CodyGargar/dbf-carrier-board/kicad/drc-report.txt

** Drc report for /home/user/dbf-carrier-board/kicad/dbf-carrier-routed-raw.kicad_pcb **
** Created on 2026-11-07 18:07:31 **

** Found 157 DRC violations **
[silk_overlap]: Silkscreen overlap
    Rule: board setup constraints silk; Severity: warning
    @(155.7700 mm, 153.6700 mm): Line on F.Silkscreen
    @(153.2300 mm, 153.7300 mm): Line on F.Silkscreen
[silk_overlap]: Silkscreen overlap
    Rule: board setup constraints silk; Severity: warning
    @(155.7700 mm, 153.6700 mm): Line on F.Silkscreen
    @(173.5500 mm, 153.7300 mm): Line on F.Silkscreen
[silk_overlap]: Silkscreen overlap
    Rule: board setup constraints silk; Severity: warning
    @(155.7700 mm, 156.2100 mm): Line on F.Silkscreen
    @(173.5500 mm, 153.7300 mm): Line on F.Silkscreen
[silk_overlap]: Silkscreen overlap
    Rule: board setup constraints silk; Severity: warning
    @(155.7700 mm, 156.2100 mm): Line on F.Silkscreen
    @(173.6100 mm, 156.3300 mm): Line on F.Silkscreen
[silk_overlap]: Silkscreen overlap
    Rule: board setup constraints silk; Severity: warning
    @(155.7700 mm, 156.2100 mm): Line on F.Silkscreen
    @(155.7700 mm, 156.3300 mm): Line on F.Silkscreen
[silk_overlap]: Silkscreen overlap
    Rule: board setup constraints silk; Severity: warning
    @(153.2300 mm, 153.7300 mm): Line on F.Silkscreen
    @(173.6100 mm, 156.3300 mm): Line on F.Silkscreen
[silk_overlap]: Silkscreen overlap
    Rule: board setup constraints silk; Severity: warning
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
[courtyards_overlap]: Courtyards overlap
    Rule: board setup constraints courtyard; Severity: error
    @(110.5000 mm, 157.5400 mm): Footprint J22
    @(110.5000 mm, 155.0000 mm): Footprint J21

** Found 0 unconnected pads **

** Found 0 Footprint errors **

** End of Report **
