CodyGargar/dbf-carrier-board/pinout.csv

Teensy pin | Function | Bus | Connects to | Notes
2 | Servo out CH1 | PWM | Mux U6 A1 | Stabilized surface (e.g. left aileron)
3 | Servo out CH2 | PWM | Mux U6 A2 | Stabilized surface (e.g. right aileron)
4 | Servo out CH3 | PWM | Mux U6 A3 | Stabilized surface (e.g. elevator)
5 | Servo out CH4 | PWM | Mux U6 A4 | Stabilized surface (e.g. rudder)
6 | Servo out CH5 | PWM | Mux U7 A1 | Stabilized surface (e.g. left flap)
9 | Servo out CH6 | PWM | Mux U7 A2 | Stabilized surface (e.g. right flap)
22 | Throttle out CH7 (T) | PWM | Mux U7 A3 | Through open-drain buffer U9 to ESC; Castle Link Live. T column + pin not connected (ESC BEC isolated)
23 | Spare out CH8 | PWM | Mux U7 A4 | Spare
24 | Watchdog heartbeat | GPIO out | U8 74LVC1G123 | Toggle from main loop; stops = receiver takes over
25 | Failover status | GPIO in | U8 Q output | High = Teensy in control
28 | ESC telemetry (Castle Link Live) | GPIO in | Throttle line via 1k | Times the ESC's reply pulses on the throttle wire
0 | Test radio RX1 | Serial1 | J11 | SiK / ESP32 for test flights only; unplug for competition
1 | Test radio TX1 | Serial1 | J11
10 | IMU CS | SPI | ICM-42688-P
11 | IMU MOSI | SPI | ICM-42688-P
12 | IMU MISO | SPI | ICM-42688-P
13 | IMU SCK | SPI | ICM-42688-P
30 | IMU INT | GPIO in | ICM-42688-P | Data-ready interrupt
14 | Receiver CRSF TX3 | Serial3 | J6 pin 3 | Telemetry to radio; to ER8 RX
15 | Receiver CRSF RX3 | Serial3 | J6 pin 4 | Sticks from radio; from ER8 TX. J6 pin 1 GND; pin 2 receiver +5V not connected
16 | Airspeed SCL1 | Wire1 | J4
17 | Airspeed SDA1 | Wire1 | J4
18 | Baro SDA | Wire | DPS368
19 | Baro SCL | Wire | DPS368
32 | Event button | GPIO in | SW1 | Hold at power-up = calibrate; tap = log mark / start-stop
33 | Buzzer | GPIO out | Q1
36 | LED green | GPIO out | D2
37 | LED red | GPIO out | D3
40 | Battery V (A16) | Analog | J7 | Optional power module
41 | Battery I (A17) | Analog | J7 | Optional power module
VIN | 5 V in | Power | Schottky from 5 V regulator
GND | Ground | Power
3V3 | Not used as supply | Power |  | Sensors use their own 3.3 V LDO
7 8 20 21 26 27 29 31 34 35 38 39 | Unused
