CodyGargar/dbf-carrier-board/kicad/board-inner-planes.png

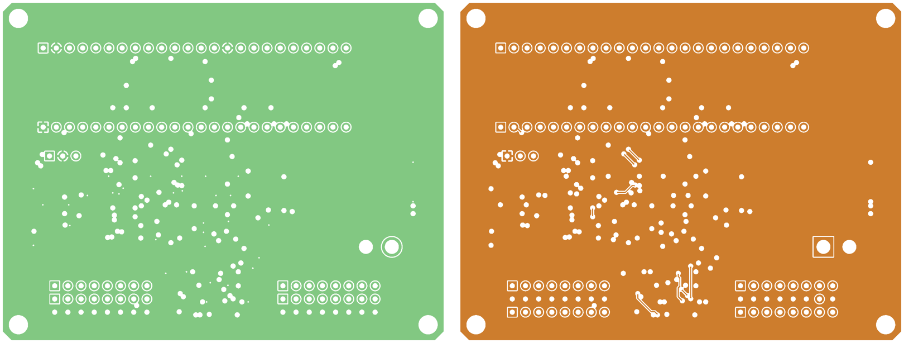
kicad/board-inner-planes.png
