CodyGargar/dbf-carrier-board/bom.csv

Section | Item | Part / model | Qty | Unit price ($) | Line total ($) | Link | Price status | Notes
A. Plane electronics (one set per plane) | Microcontroller | Teensy 4.1 (DEV-16771) | 1 | 31.5 | 31.5 | https://www.sparkfun.com/teensy-4-1.html | Checked 2026-10-12 | SparkFun now makes Teensy. Comes without pins.
A. Plane electronics (one set per plane) | Pins for the Teensy | Male header, 24-pin, 0.1in | 2 | 1.85 | 3.7 | https://www.sparkfun.com/straight-header-male-gold-plating-pth-0-1in-24-pin.html | Checked 2026-10-12 | Solder these onto the Teensy so it plugs into the board.
A. Plane electronics (one set per plane) | Airspeed sensor | Matek ASPD-4525 (MS4525DO) | 1 | 59.99 | 59.99 | https://racedayquads.com/products/matek-analog-airspeed-sensor-aspd-4525 | Checked 2026-10-12 | Kit includes pitot tube and rubber tubing.
A. Plane electronics (one set per plane) | RC receiver | RadioMaster ER8 ELRS PWM (team already has) | 0 | 0 | 0 | https://www.radiomasterrc.com/products/er8-2-4ghz-elrs-pwm-receiver | Already owned | 8 PWM + 4-pin CRSF port. Needs 7 backup channels + 1 for the drop servos. An ER6 is too small.
A. Plane electronics (one set per plane) | Y-cable for the 2 drop servos | Servo Y-harness | 1 | 3 | 3 | https://www.amazon.com/s?k=servo+y+harness | Estimate | Both drop servos on receiver channel 8.
A. Plane electronics (one set per plane) | ESC programmer | Castle Link USB programming kit | 1 | 30 | 30 | https://www.castlecreations.com/en/castle-link-usb-programming-kit-011-0119-00 | Estimate | Turns on Link Live telemetry and disables the BEC. Skip if the team owns one.
A. Plane electronics (one set per plane) | Test radio for laptop (testing only) | SiK telemetry radio pair, 915 MHz | 1 | 60 | 60 | https://www.amazon.com/s?k=sik+telemetry+radio+915mhz | Estimate | Unplug for competition: stand-alone telemetry radios are banned there. USB works on the bench for free.
A. Plane electronics (one set per plane) | Battery current sensing (backup) | Holybro PM02 V3 (sense only) | 0 | 18.99 | 0.0 | https://holybro.com/products/pm02-v3-12s-power-module | Checked 2026-10-12 | Not needed: the Castle ESC reports current over Link Live. Set qty 1 only if Link Live doesn't work out.
A. Plane electronics (one set per plane) | Cables for airspeed / receiver / sensing | JST-GH 1.25 mm pre-crimped cable kit | 1 | 12 | 12 | https://www.amazon.com/s?k=JST+GH+1.25mm+pre-crimped+cable | Estimate | Get 2-, 4- and 6-pin, 15-20 cm.
B. Board order (JLCPCB: 5 bare boards, 2 assembled) | Bare PCBs | 4-layer, ~86 x 66 mm, qty 5 | 1 | 10 | 10 | https://jlcpcb.com/quote | Estimate | Get the real price by uploading the Gerber files once the design is finished.
B. Board order (JLCPCB: 5 bare boards, 2 assembled) | Assembly setup + stencil | JLCPCB PCBA, economic, 2 boards | 1 | 12 | 12 | https://jlcpcb.com/quote | Estimate | Assembling only 2 of the 5 boards saves money because the IMU is expensive.
B. Board order (JLCPCB: 5 bare boards, 2 assembled) | Extended-part fees | ~8 part types x ~$3 | 1 | 24 | 24 | https://jlcpcb.com/quote | Estimate | JLCPCB charges a loading fee per uncommon part type.
B. Board order (JLCPCB: 5 bare boards, 2 assembled) | IMU (factory soldered) | TDK ICM-42688-P (LCSC C1850418) | 2 | 20.5 | 41.0 | https://www.lcsc.com/product-detail/C1850418.html | Checked 2026-10-12 | 355 in stock when checked.
B. Board order (JLCPCB: 5 bare boards, 2 assembled) | Barometer (factory soldered) | Infineon DPS368XTSA1 (LCSC C3232508) | 2 | 4.42 | 8.84 | https://www.lcsc.com/product-detail/C3232508.html | Checked 2026-10-12 | Replaces DPS310 (out of stock). Pinout to be confirmed during the schematic step.
B. Board order (JLCPCB: 5 bare boards, 2 assembled) | 3.3 V regulator | AP2112K-3.3 | 2 | 0.3 | 0.6 | https://jlcpcb.com/parts/componentSearch?searchTxt=AP2112K-3.3 | Estimate
B. Board order (JLCPCB: 5 bare boards, 2 assembled) | Failover mux (factory soldered) | TI SN74LVC157A, TSSOP-16 | 4 | 0.35 | 1.4 | https://jlcpcb.com/parts/componentSearch?searchTxt=SN74LVC157APWR | Estimate | 2 per board: hands servos back to the receiver.
B. Board order (JLCPCB: 5 bare boards, 2 assembled) | Watchdog timer (factory soldered) | 74LVC1G123, VSSOP-8 | 2 | 0.45 | 0.9 | https://jlcpcb.com/parts/componentSearch?searchTxt=74LVC1G123 | Estimate | Switches to the receiver if the Teensy stops.
B. Board order (JLCPCB: 5 bare boards, 2 assembled) | Throttle buffer (factory soldered) | 74LVC1G07, SOT-353 | 2 | 0.15 | 0.3 | https://jlcpcb.com/parts/componentSearch?searchTxt=74LVC1G07 | Estimate | Open-drain stage for Castle Link Live.
B. Board order (JLCPCB: 5 bare boards, 2 assembled) | JST-GH 6-pin connector (factory soldered) | JST SM06B-GHS-TB | 2 | 0.8 | 1.6 | https://www.digikey.com/en/products/result?keywords=SM06B-GHS-TB | Estimate | Battery V/I sensing.
B. Board order (JLCPCB: 5 bare boards, 2 assembled) | JST-GH 4-pin connector (factory soldered) | JST SM04B-GHS-TB | 6 | 0.7 | 4.2 | https://www.digikey.com/en/products/result?keywords=SM04B-GHS-TB | Estimate | 3 per board: airspeed, receiver CRSF, test radio.
B. Board order (JLCPCB: 5 bare boards, 2 assembled) | Buzzer (factory soldered) | CUI CMT-8504-100-SMT | 2 | 1.8 | 3.6 | https://www.digikey.com/en/products/result?keywords=CMT-8504-100-SMT | Estimate
B. Board order (JLCPCB: 5 bare boards, 2 assembled) | Small parts per board | Resistors, caps, LEDs, diode, transistor | 2 | 2 | 4 | https://jlcpcb.com/parts/componentSearch?searchTxt=0603 | Estimate | Mostly JLCPCB basic parts (cents each).
B. Board order (JLCPCB: 5 bare boards, 2 assembled) | Shipping + import fees | JLCPCB to US | 1 | 30 | 30 | https://jlcpcb.com/quote | Estimate | Biggest unknown; check at checkout.
C. Parts you solder yourself (for the 2 assembled boards) | 5 V regulator module | Pololu S7V7F5 (2.7-11.8 V in) | 2 | 8.49 | 16.98 | https://www.pololu.com/product/2119 | Checked 2026-10-17 | Runs the board from the receiver battery.
C. Parts you solder yourself (for the 2 assembled boards) | Teensy sockets | Female header 1x24, gold (2-pack) | 2 | 0.85 | 1.7 | https://protosupplies.com/product/header-female-1x24-gold-2-pack/ | Checked 2026-10-12 | One 2-pack per board.
C. Parts you solder yourself (for the 2 assembled boards) | Servo headers | Male header 1x8, 0.1in | 12 | 0.4 | 4.8 | https://www.digikey.com/en/products/result?keywords=1x8+male+header+2.54 | Estimate | 6 per board: two 3x8 blocks (from receiver, to servos).
C. Parts you solder yourself (for the 2 assembled boards) | Receiver battery input | AMASS XT30U male, PCB | 2 | 1 | 2 | https://www.digikey.com/en/products/result?keywords=XT30 | Estimate | From the external radio switch.
C. Parts you solder yourself (for the 2 assembled boards) | Event button | 6 mm tactile switch (TL3342 footprint) | 2 | 0.4 | 0.8 | https://www.digikey.com/en/products/result?keywords=TL3342 | Estimate
