CodyGargar/dbf-carrier-board/parts-list.xlsx

DBF Logger + Stabilizer Rev B: Parts List
Prices marked "Checked" were read from the seller page in October 2026; "Estimate" rows are ballpark. Change any Qty cell (blue) and totals update.
Item | Part / model | Qty | Unit price ($) | Line total ($) | Buy link | Price status | Notes
A. Plane electronics (one set per plane)
Microcontroller | Teensy 4.1 (DEV-16771) | 1 | $31.50 |  | Open link (https://www.sparkfun.com/teensy-4-1.html) | Checked 2026-10-12 | SparkFun now makes Teensy. Comes without pins.
Pins for the Teensy | Male header, 24-pin, 0.1in | 2 | $1.85 |  | Open link (https://www.sparkfun.com/straight-header-male-gold-plating-pth-0-1in-24-pin.html) | Checked 2026-10-12 | Solder these onto the Teensy so it plugs into the board.
Airspeed sensor | Matek ASPD-4525 (MS4525DO) | 1 | $59.99 |  | Open link (https://racedayquads.com/products/matek-analog-airspeed-sensor-aspd-4525) | Checked 2026-10-12 | Kit includes pitot tube and rubber tubing.
RC receiver | RadioMaster ER8 ELRS PWM (team already has) | 0 | $0.00 |  | Open link (https://www.radiomasterrc.com/products/er8-2-4ghz-elrs-pwm-receiver) | Already owned | 8 PWM + 4-pin CRSF port. Needs 7 backup channels + 1 for the drop servos. An ER6 is too small.
Y-cable for the 2 drop servos | Servo Y-harness | 1 | $3.00 |  | Open link (https://www.amazon.com/s?k=servo+y+harness) | Estimate | Both drop servos on receiver channel 8.
ESC programmer | Castle Link USB programming kit | 1 | $30.00 |  | Open link (https://www.castlecreations.com/en/castle-link-usb-programming-kit-011-0119-00) | Estimate | Turns on Link Live telemetry and disables the BEC. Skip if the team owns one.
Test radio for laptop (testing only) | SiK telemetry radio pair, 915 MHz | 1 | $60.00 |  | Open link (https://www.amazon.com/s?k=sik+telemetry+radio+915mhz) | Estimate | Unplug for competition: stand-alone telemetry radios are banned there. USB works on the bench for free.
Battery current sensing (backup) | Holybro PM02 V3 (sense only) | 0 | $18.99 |  | Open link (https://holybro.com/products/pm02-v3-12s-power-module) | Checked 2026-10-12 | Not needed: the Castle ESC reports current over Link Live. Set qty 1 only if Link Live doesn't work out.
Cables for airspeed / receiver / sensing | JST-GH 1.25 mm pre-crimped cable kit | 1 | $12.00 |  | Open link (https://www.amazon.com/s?k=JST+GH+1.25mm+pre-crimped+cable) | Estimate | Get 2-, 4- and 6-pin, 15-20 cm.
 |  |  | Subtotal
B. Board order (JLCPCB: 5 bare boards, 2 assembled)
Bare PCBs | 4-layer, ~86 x 66 mm, qty 5 | 1 | $10.00 |  | Open link (https://jlcpcb.com/quote) | Estimate | Get the real price by uploading the Gerber files once the design is finished.
Assembly setup + stencil | JLCPCB PCBA, economic, 2 boards | 1 | $12.00 |  | Open link (https://jlcpcb.com/quote) | Estimate | Assembling only 2 of the 5 boards saves money because the IMU is expensive.
Extended-part fees | ~8 part types x ~$3 | 1 | $24.00 |  | Open link (https://jlcpcb.com/quote) | Estimate | JLCPCB charges a loading fee per uncommon part type.
IMU (factory soldered) | TDK ICM-42688-P (LCSC C1850418) | 2 | $20.50 |  | Open link (https://www.lcsc.com/product-detail/C1850418.html) | Checked 2026-10-12 | 355 in stock when checked.
Barometer (factory soldered) | Infineon DPS368XTSA1 (LCSC C3232508) | 2 | $4.42 |  | Open link (https://www.lcsc.com/product-detail/C3232508.html) | Checked 2026-10-12 | Replaces DPS310 (out of stock). Pinout to be confirmed during the schematic step.
3.3 V regulator | AP2112K-3.3 | 2 | $0.30 |  | Open link (https://jlcpcb.com/parts/componentSearch?searchTxt=AP2112K-3.3) | Estimate
Failover mux (factory soldered) | TI SN74LVC157A, TSSOP-16 | 4 | $0.35 |  | Open link (https://jlcpcb.com/parts/componentSearch?searchTxt=SN74LVC157APWR) | Estimate | 2 per board: hands servos back to the receiver.
Watchdog timer (factory soldered) | 74LVC1G123, VSSOP-8 | 2 | $0.45 |  | Open link (https://jlcpcb.com/parts/componentSearch?searchTxt=74LVC1G123) | Estimate | Switches to the receiver if the Teensy stops.
Throttle buffer (factory soldered) | 74LVC1G07, SOT-353 | 2 | $0.15 |  | Open link (https://jlcpcb.com/parts/componentSearch?searchTxt=74LVC1G07) | Estimate | Open-drain stage for Castle Link Live.
JST-GH 6-pin connector (factory soldered) | JST SM06B-GHS-TB | 2 | $0.80 |  | Open link (https://www.digikey.com/en/products/result?keywords=SM06B-GHS-TB) | Estimate | Battery V/I sensing.
JST-GH 4-pin connector (factory soldered) | JST SM04B-GHS-TB | 6 | $0.70 |  | Open link (https://www.digikey.com/en/products/result?keywords=SM04B-GHS-TB) | Estimate | 3 per board: airspeed, receiver CRSF, test radio.
Buzzer (factory soldered) | CUI CMT-8504-100-SMT | 2 | $1.80 |  | Open link (https://www.digikey.com/en/products/result?keywords=CMT-8504-100-SMT) | Estimate
Small parts per board | Resistors, caps, LEDs, diode, transistor | 2 | $2.00 |  | Open link (https://jlcpcb.com/parts/componentSearch?searchTxt=0603) | Estimate | Mostly JLCPCB basic parts (cents each).
Shipping + import fees | JLCPCB to US | 1 | $30.00 |  | Open link (https://jlcpcb.com/quote) | Estimate | Biggest unknown; check at checkout.
 |  |  | Subtotal
C. Parts you solder yourself (for the 2 assembled boards)
5 V regulator module | Pololu S7V7F5 (2.7-11.8 V in) | 2 | $8.49 |  | Open link (https://www.pololu.com/product/2119) | Checked 2026-10-17 | Runs the board from the receiver battery.
Teensy sockets | Female header 1x24, gold (2-pack) | 2 | $0.85 |  | Open link (https://protosupplies.com/product/header-female-1x24-gold-2-pack/) | Checked 2026-10-12 | One 2-pack per board.
Servo headers | Male header 1x8, 0.1in | 12 | $0.40 |  | Open link (https://www.digikey.com/en/products/result?keywords=1x8+male+header+2.54) | Estimate | 6 per board: two 3x8 blocks (from receiver, to servos).
Receiver battery input | AMASS XT30U male, PCB | 2 | $1.00 |  | Open link (https://www.digikey.com/en/products/result?keywords=XT30) | Estimate | From the external radio switch.
Event button | 6 mm tactile switch (TL3342 footprint) | 2 | $0.40 |  | Open link (https://www.digikey.com/en/products/result?keywords=TL3342) | Estimate
 |  |  | Subtotal
 |  |  | TOTAL
Not included: receiver battery + external radio switch, servos, ESC, motor, propulsion battery, fuse harness, arming plug, RC transmitter. Not allowed by the 2027 rules: GPS.
