CodyGargar/dbf-carrier-board/jlcpcb/bom-jlcpcb.csv

Comment | Designator | Footprint | LCSC Part #
CMT-8504-100-SMT-TR | BZ1 | MagneticBuzzer_CUI_CMT-8504-100-SMT
10uF 25V X5R 0805 | C1,C2 | C_0805_2012Metric
100nF X7R 0603 | C3,C4,C6,C8,C9,C10,C11 | C_0603_1608Metric
10nF X7R 0603 | C5 | C_0603_1608Metric
0.47uF X7R 0603 (watchdog timing) | C7 | C_0603_1608Metric
2.2uF X7R 0603 | C12 | C_0603_1608Metric
SS24 (SMA) | D1 | D_SMA
Green LED 0603 | D2 | LED_0603_1608Metric
Red LED 0603 | D3 | LED_0603_1608Metric
1N4148W (SOD-123) | D4 | D_SOD-123
SM04B-GHS-TB(LF)(SN) | J4,J6,J11 | JST_GH_SM04B-GHS-TB_1x04-1MP_P1.25mm_Horizontal
SM06B-GHS-TB(LF)(SN) | J7 | JST_GH_SM06B-GHS-TB_1x06-1MP_P1.25mm_Horizontal
MMBT3904 | Q1 | SOT-23
10k | R1,R9 | R_0603_1608Metric
4.7k | R2,R3 | R_0603_1608Metric
2.2k | R4,R5 | R_0603_1608Metric
1k | R6,R7,R10 | R_0603_1608Metric
100k 1% (watchdog timing) | R8 | R_0603_1608Metric
100k | R11 | R_0603_1608Metric
18R 0805 | R12 | R_0805_2012Metric
TL3342F160QG | SW1 | SW_SPST_TL3342
ICM-42688-P | U2 | Bosch_LGA-14_3x2.5mm_P0.5mm
DPS368XTSA1 | U3 | Bosch_LGA-8_2x2.5mm_P0.65mm_ClockwisePinNumbering
AP2112K-3.3TRG1 | U4 | SOT-23-5
SN74LVC157APWR | U6,U7 | TSSOP-16_4.4x5mm_P0.65mm
SN74LVC1G123DCUR | U8 | VSSOP-8_2.3x2mm_P0.5mm
SN74LVC1G07DCKR | U9 | SOT-353_SC-70-5
