CodyGargar/dbf-carrier-board/wiring/avionics-wiring.png

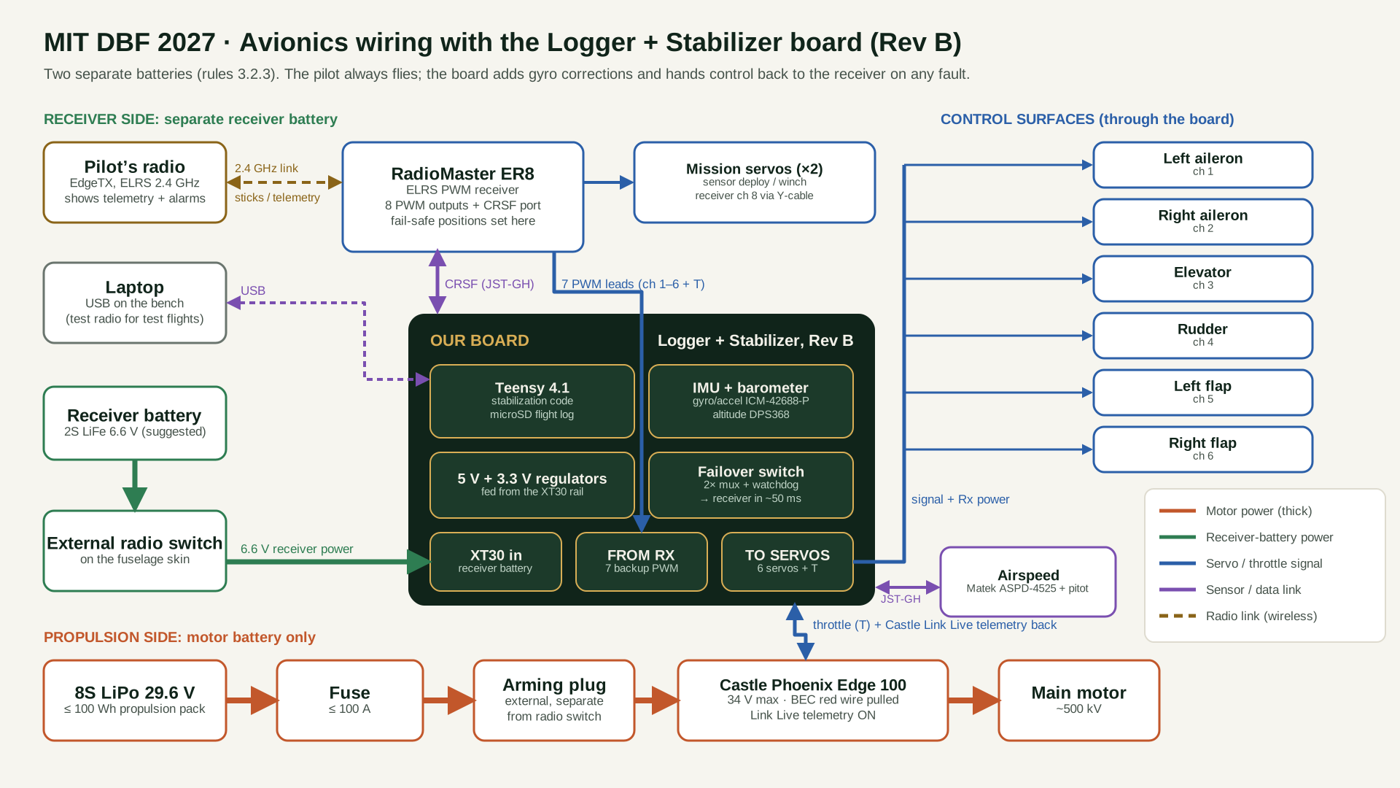
wiring/avionics-wiring.png
