CodyGargar/dbf-carrier-board/kicad/dbf-carrier.kicad_pcb

## KiCad design kicad/dbf-carrier.kicad_pcb (2026-11-07)

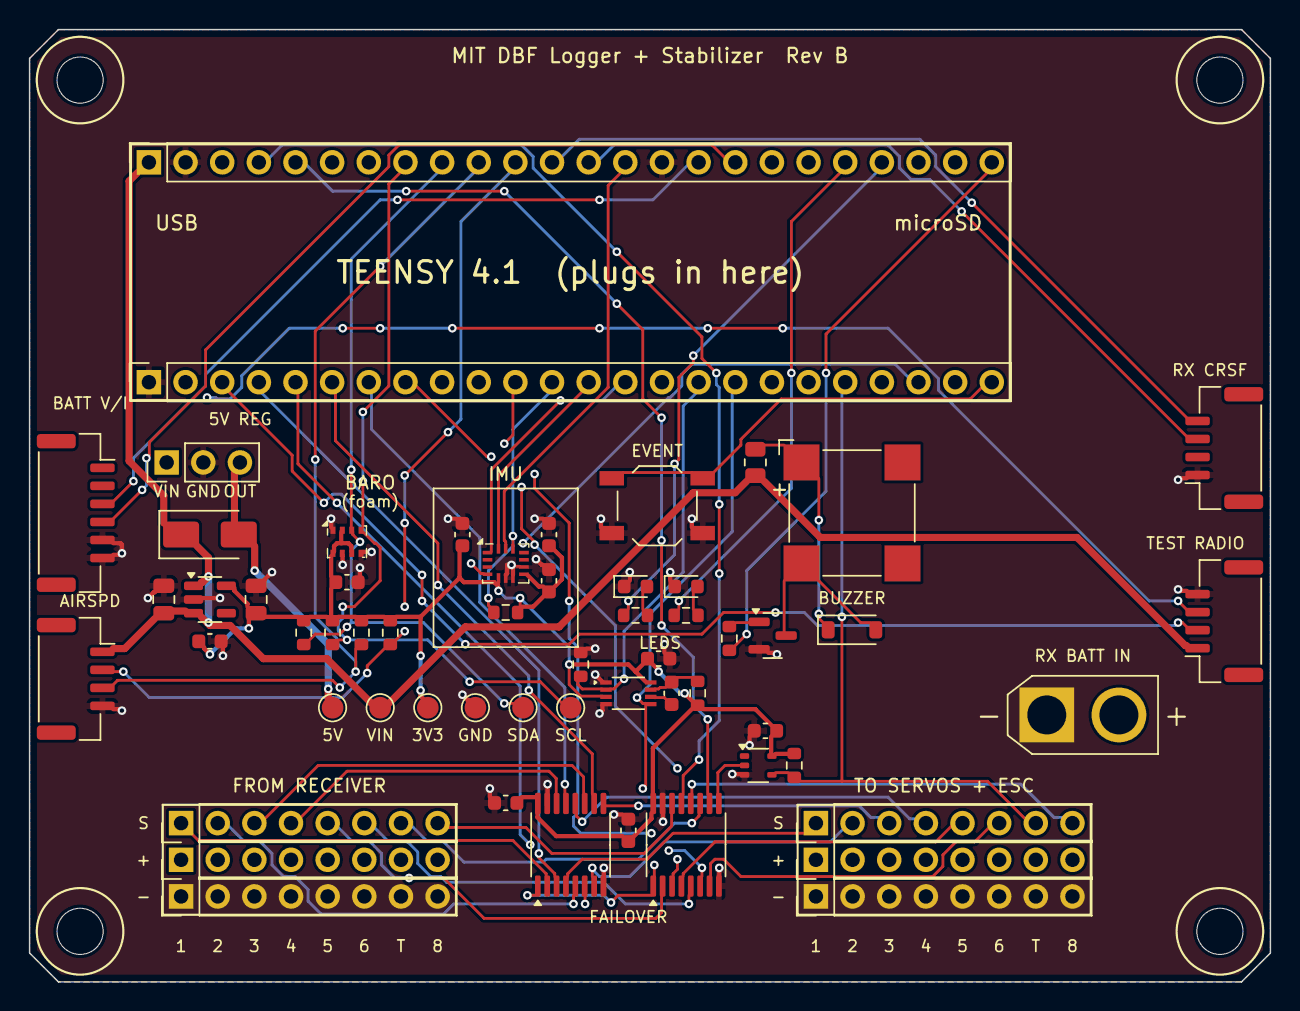
[picture p4: board dbf-carrier.kicad_pcb from above]

Board: 4 copper layers, 86.0 x 66.0 mm, 62 parts (0 on the bottom side), 58 nets.

Parts:
BZ1: Buzzer; MagneticBuzzer_CUI_CMT-8504-100-SMT
C1, C2: 10uF; C_0805_2012Metric
C3, C4, C5, C6, C8, C9, C10, C11: 100nF; C_0603_1608Metric
C7: watchdog RC; C_0603_1608Metric
C12: 2.2uF; C_0603_1608Metric
D1: SS24 Schottky; D_SMA
D2: GRN; LED_0603_1608Metric
D3: RED; LED_0603_1608Metric
D4: 1N4148W flyback; D_SOD-123
H1, H2, H3, H4: M3; MountingHole_3.2mm_M3
J1: Teensy row A; PinSocket_1x24_P2.54mm_Vertical
J2: Teensy row B; PinSocket_1x24_P2.54mm_Vertical
J4: Airspeed; JST_GH_SM04B-GHS-TB_1x04-1MP_P1.25mm_Horizontal
J6: RX CRSF; JST_GH_SM04B-GHS-TB_1x04-1MP_P1.25mm_Horizontal
J7: Power module (sense only); JST_GH_SM06B-GHS-TB_1x06-1MP_P1.25mm_Horizontal
J11: Test radio (testing only); JST_GH_SM04B-GHS-TB_1x04-1MP_P1.25mm_Horizontal
J12: Rx battery in (from radio switch); AMASS_XT30U-M_1x02_P5.0mm_Vertical
J21: FROM RECEIVER S; PinHeader_1x08_P2.54mm_Vertical
J22: FROM RECEIVER +; PinHeader_1x08_P2.54mm_Vertical
J23: FROM RECEIVER -; PinHeader_1x08_P2.54mm_Vertical
J31: TO SERVOS + ESC S; PinHeader_1x08_P2.54mm_Vertical
J32: TO SERVOS + ESC +; PinHeader_1x08_P2.54mm_Vertical
J33: TO SERVOS + ESC -; PinHeader_1x08_P2.54mm_Vertical
Q1: MMBT3904 NPN; SOT-23
R1: 10k CS pull-up; R_0603_1608Metric
R2: 4.7k SDA; R_0603_1608Metric
R3: 4.7k SCL; R_0603_1608Metric
R4: 2.2k SDA1; R_0603_1608Metric
R5: 2.2k SCL1; R_0603_1608Metric
R6, R7: 1k; R_0603_1608Metric
R8: watchdog RC; R_0603_1608Metric
R9: 10k throttle pull-up; R_0603_1608Metric
R10: 1k buzzer base; R_0603_1608Metric
R11: 100k heartbeat pull-down; R_0603_1608Metric
R12: 18R buzzer current limit; R_0805_2012Metric
SW1: Event button; SW_SPST_TL3342
TP1: 5V; TestPoint_Pad_D1.5mm
TP2: VIN; TestPoint_Pad_D1.5mm
TP3: 3V3; TestPoint_Pad_D1.5mm
TP4: GND; TestPoint_Pad_D1.5mm
TP5: SDA; TestPoint_Pad_D1.5mm
TP6: SCL; TestPoint_Pad_D1.5mm
U2: ICM-42688-P; Bosch_LGA-14_3x2.5mm_P0.5mm
U3: DPS368; Bosch_LGA-8_2x2.5mm_P0.65mm_ClockwisePinNumbering
U4: AP2112K-3.3; SOT-23-5
U5: Pololu S7V7F5 5V reg; PinHeader_1x03_P2.54mm_Vertical
U6: SN74LVC157A ch1-4; TSSOP-16_4.4x5mm_P0.65mm
U7: SN74LVC157A ch5-8; TSSOP-16_4.4x5mm_P0.65mm
U8: 74LVC1G123 watchdog; VSSOP-8_2.3x2mm_P0.5mm
U9: 74LVC1G07 throttle open-drain; SOT-353_SC-70-5

Connections:
+3V3S: C2.1, C3.1, C4.1, C5.1, C6.1, C8.2, C9.1, C10.1, C11.2, C12.1, R1.2, R2.2, R3.2, R4.2, R5.2, R8.2, R9.2, TP3.1, U2.5, U2.8, U3.2, U3.6, U3.8, U4.5, U6.16, U7.16, U8.3, U8.8, U9.5
+5V: D1.2, TP1.1, U5.3
BATT_I: J1.16, J7.3
BATT_V: J1.17, J7.4
BTN: J2.24, SW1.1
BUZ: J1.24, R10.1
BUZ_B: Q1.1, R10.2
BUZ_C: BZ1.2, D4.2, Q1.3
BUZ_P: BZ1.1, D4.1, R12.2
CRSF_RX: J1.12, J6.4
CRSF_TX: J1.13, J6.3
GND: C1.2, C2.2, C3.2, C4.2, C5.2, C6.2, C8.1, C9.2, C10.2, C11.1, C12.2, D2.1, D3.1, J1.2, J1.15, J2.1, J4.4, J6.1, J7.5, J7.6, J11.4, J12.1, J23.1, J23.2, J23.3, J23.4, J23.5, J23.6, J23.7, J23.8, J33.1, J33.2, J33.3, J33.4, J33.5, J33.6, J33.7, J33.8, Q1.2, R11.2, SW1.2, TP4.1, U2.6, U2.7, U2.9, U3.1, U3.5, U3.7, U4.2, U5.2, U6.8, U6.15, U7.8, U7.15, U8.1, U8.4, U9.3
HEARTBEAT: J2.16, R11.1, U8.2
IMU_CS: J2.12, R1.1, U2.12
IMU_INT: J2.22, U2.4
IMU_MISO: J2.14, U2.1
IMU_MOSI: J2.13, U2.14
IMU_SCK: J1.14, U2.13
LED_G: J1.21, R6.1
LED_G_A: D2.2, R6.2
LED_R: J1.20, R7.1
LED_R_A: D3.2, R7.2
OUT_CH1: J31.1, U6.4
OUT_CH2: J31.2, U6.7
OUT_CH3: J31.3, U6.9
OUT_CH4: J31.4, U6.12
OUT_CH5: J31.5, U7.4
OUT_CH6: J31.6, U7.7
OUT_CH8: J31.8, U7.12
OUT_T: J2.20, J31.7, R9.1, U9.4
PWM_CH1: J2.4, U6.3
PWM_CH2: J2.5, U6.6
PWM_CH3: J2.6, U6.10
PWM_CH4: J2.7, U6.13
PWM_CH5: J2.8, U7.3
PWM_CH6: J2.11, U7.6
PWM_CH8: J1.4, U7.13
PWM_CHT: J1.5, U7.10
RX_CH1: J21.1, U6.2
RX_CH2: J21.2, U6.5
RX_CH3: J21.3, U6.11
RX_CH4: J21.4, U6.14
RX_CH5: J21.5, U7.2
RX_CH6: J21.6, U7.5
RX_CH8: J21.8, U7.14
RX_CHT: J21.7, U7.11
SCL: J1.8, R3.1, TP6.1, U3.4
SCL1: J1.11, J4.2, R5.1
SDA: J1.9, R2.1, TP5.1, U3.3
SDA1: J1.10, J4.3, R4.1
TEENSY_OK: J2.17, U6.1, U7.1, U8.5
TEL_RX: J2.2, J11.3
TEL_TX: J2.3, J11.2
THR_MUX: U7.9, U9.2
VIN: C1.1, D1.1, J1.1, J4.1, J11.1, R12.1, TP2.1, U4.1, U4.3
VSERVO: J12.2, J22.1, J22.2, J22.3, J22.4, J22.5, J22.6, J22.7, J22.8, J32.1, J32.2, J32.3, J32.4, J32.5, J32.6, J32.8, U5.1
WD_C: C7.1, U8.6
WD_RC: C7.2, R8.1, U8.7
