CodyGargar/dbf-carrier-board/(commit log)

2026-10-29 Add Rev B Teensy carrier board design
    KiCad project, generator scripts, JLCPCB order files, BOM, wiring
    diagram and design docs.
    Claude-Session: https://claude.ai/code/session_01FHovDuEkN1VSxy48YnPrDz
    [bom-jlcpcb.csv, bom.csv, dbf-carrier.kicad_pcb, parts-list.xlsx, pinout.csv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]
2026-11-07 Match CRSF connector to ER8 and isolate ESC BEC
    - J6 RX CRSF now follows the RadioMaster ER8 port order (GND, +, RX, TX),
    so a pin-1-to-pin-1 JST-GH cable works; receiver 5 V pin unconnected.
    - T column + pin on TO SERVOS + ESC is unconnected so the Phoenix Edge
    100's BEC can't feed the servo rail (rules 3.2.3).
    - Rerouted, DRC rerun (0 unconnected, same cosmetic warnings), new
    Gerbers, board pictures and wiring diagram.
    - ESC is the Phoenix Edge 100 (34 V), receiver confirmed as ER8; README
    open questions, ESC setup and CRSF cable notes updated.
    Claude-Session: https://claude.ai/code/session_01FHovDvtVWbdFQHt2FHBL4S
    [dbf-carrier.kicad_pcb, pinout.csv]
2026-11-07 Close Pololu and buzzer pin-order questions; label regulator pins
    - Pololu S7V7F5: GND is the middle pin (two independent CAD libraries
    agree), which the board already matches. Added VIN / GND / OUT
    silkscreen under U5 so the module can't go in backwards.
    - CMT-8504 buzzer: + is the top-left pad (pad 1), as wired; confirmed
    against two datasheet-derived footprints.
    - Regenerated Gerbers (DRC unchanged: 0 unconnected), board picture,
    README open questions, ORDERING buzzer orientation check.
    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
    [dbf-carrier.kicad_pcb]
